Rajssss/shakti-soc/asic/e-class-aardonyx/board/README.md

# Aardonyx

FINAL SOC CONFIGURATION FOR E-CLASS:

Configuration:
1. PWM x 6
2. SPI x 3              (ADC/SDCARD/A_H)
3. GPIO x 16
4. UART x 3
5. QSPI x 1             (FLASH)
6. I2C x 2              (EEPROM/A_H)
7. SDRAM 32-bit
8. JTAG x 1 

9. FREQUENCY: 75-100Mhz
10. PACKAGE: CQFP
11. PIN COUNT MAX:103 + VCC&GND (WITH PINMUX)

Google Sheet(Aardonyx SOC I/O Pin Count):
https://docs.google.com/spreadsheets/d/1yA-pKs3_cNw3IYSj8Q-fh1bL_jA87MuPH5vjwz0L73s/edit?usp=sharing
