Rajssss/shakti-soc/asic/e-class-aardonyx/board/Board_Design/README.md

This folder contains all board design related files.

## Directory Structure

├── Aardonyx.pro        # Kicad project                     
├── board               # Kicad pcb files for Aardonyx      
├── gerber              # Gerber files for Aardonyx         
├── library             # library(symbols) used for Aardonyx  
├── modules             # moudles(footprint lib, 3d model) used for Aardonyx    
├── schematic           # schematics for Aardonyx
