Rajssss/shakti-soc/asic/e-class-aardonyx/fpga/test/artya7-100t/peripheral-tests/bsp/drivers/readme.md

This folder hosts the driver code.

List of drivers veririfed by internal testing team

Lst of drivers unverified
