Rajssss/shakti-soc/asic/e-class-aardonyx/board/Board_Design/Aardonyx.pdf

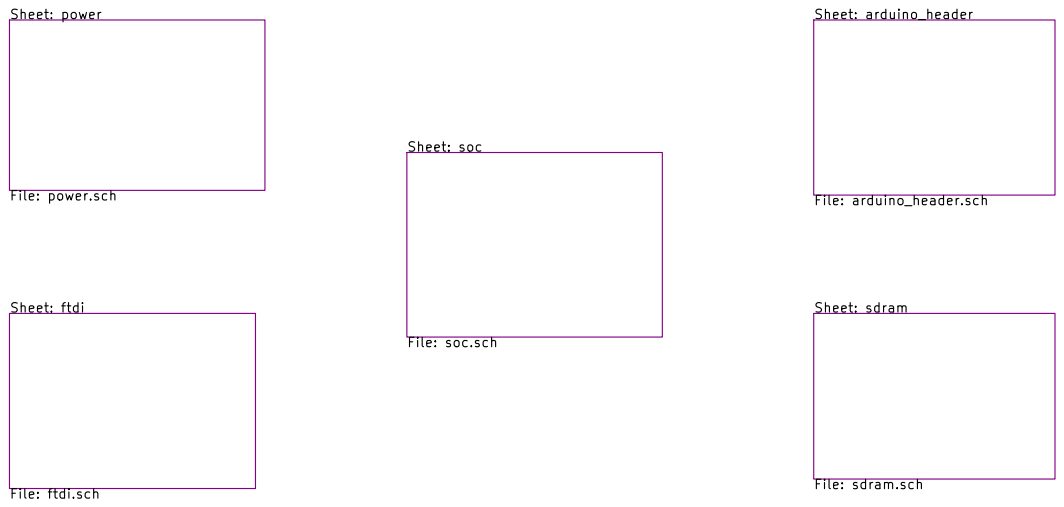
[picture p2: page 1]

File: sdram.sch Sheet: arduino_header File: arduino_header.sch Sheet: power

File: Aardonyx.sch Sheet: /
Id: 1/6 Title:

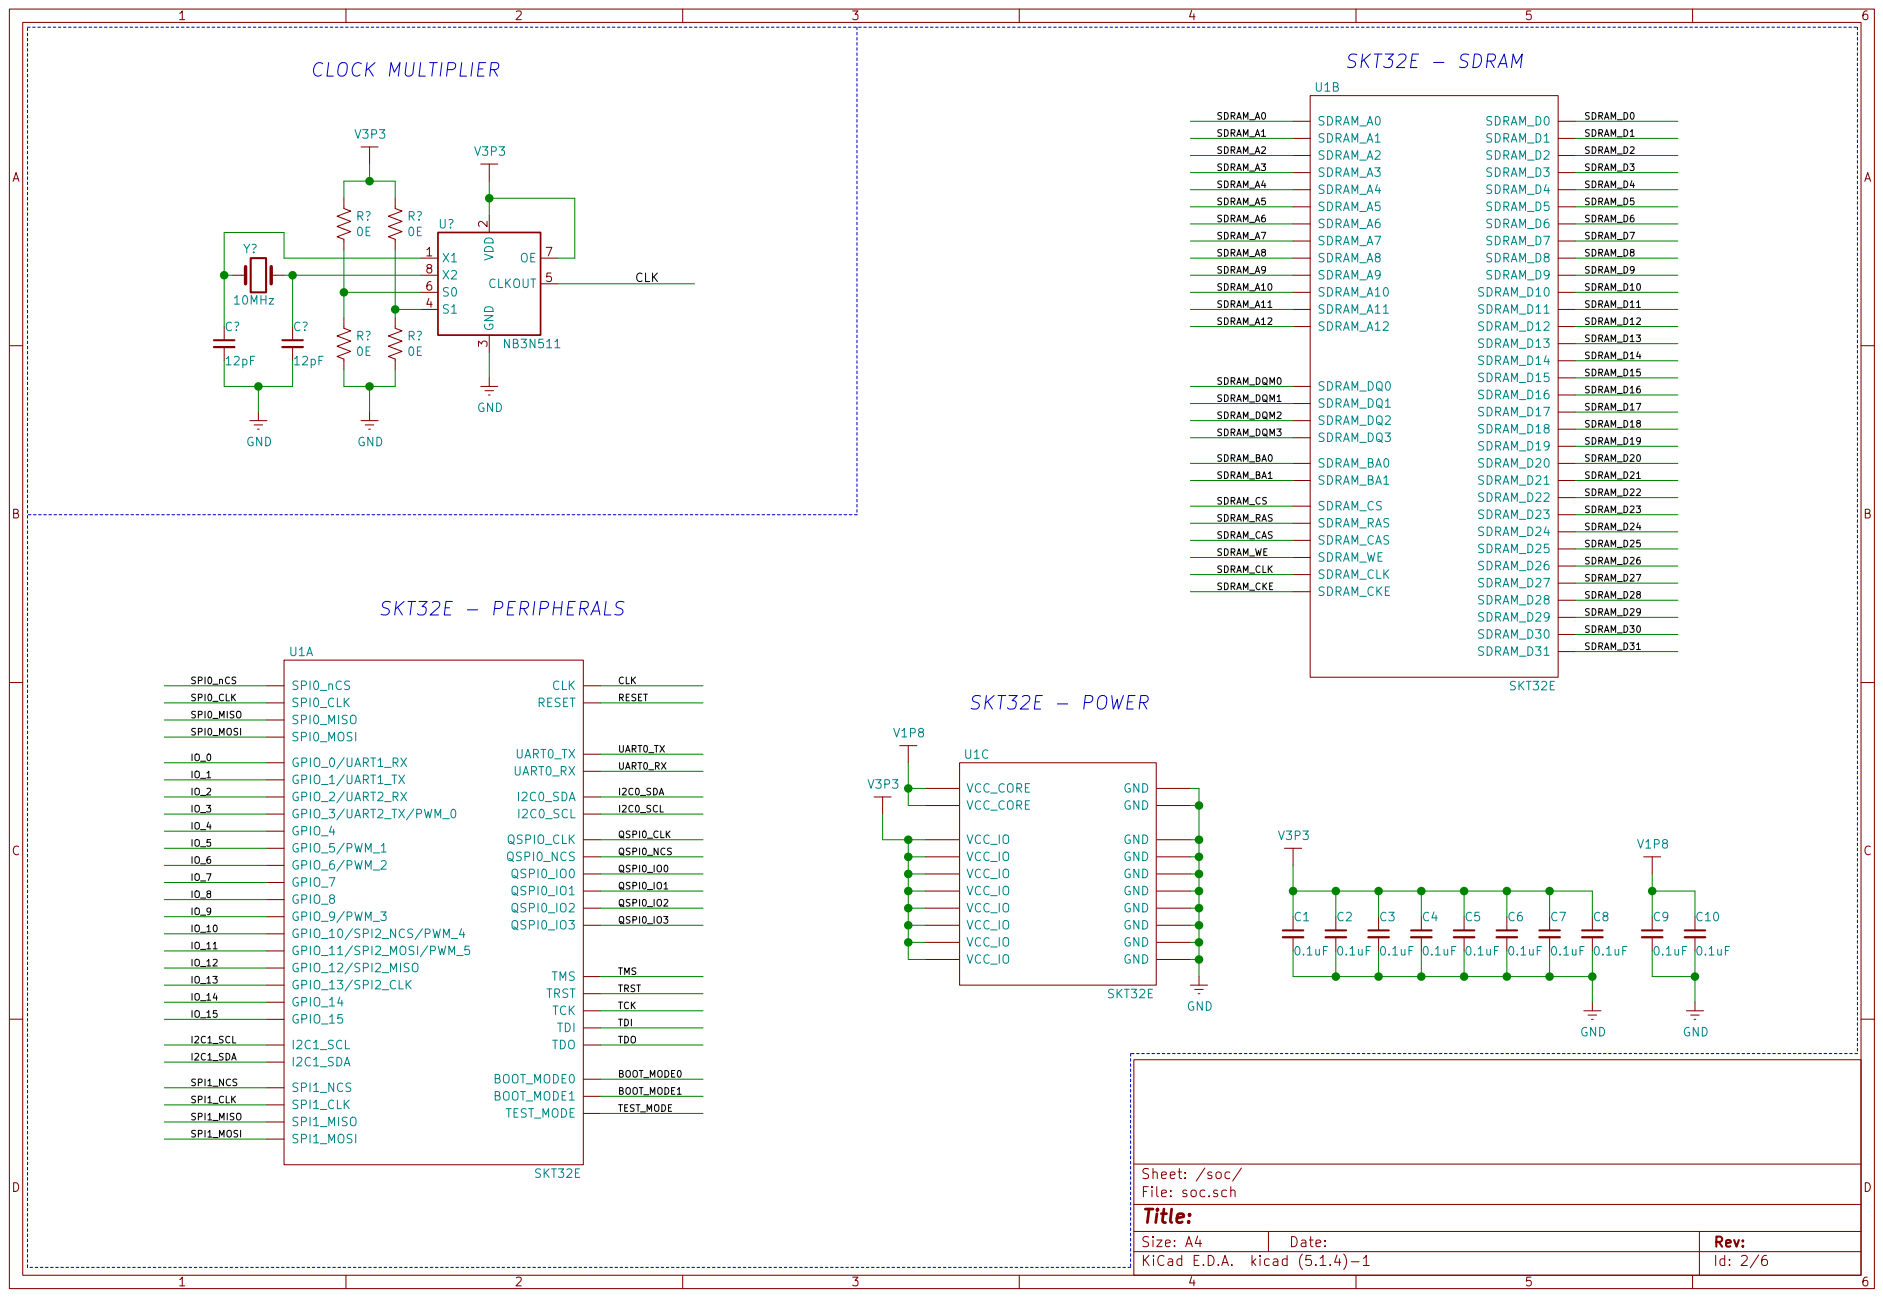
[picture p3: page 2]

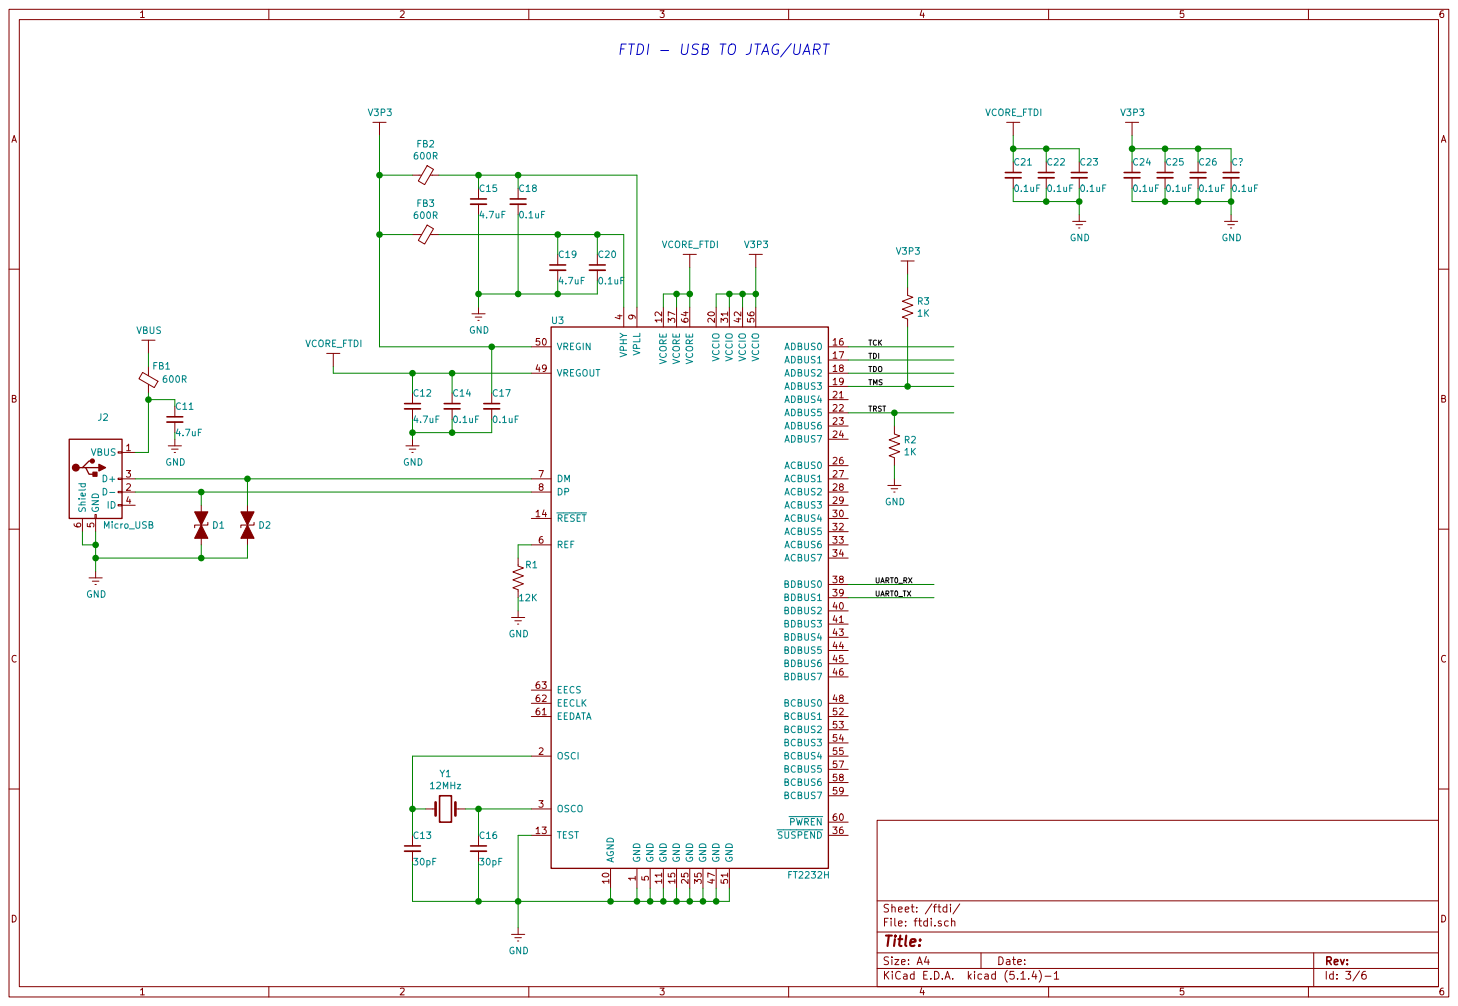
[picture p4: page 3]

TDI FTDI - USB TO JTAG/UART

1 AGND 10 GND 11 VCORE 12 TEST 13 RESET 14 GND 15 ADBUS0 16 ADBUS1 17 ADBUS2 18 ADBUS3 19 OSCI 2 VCCIO 20 ADBUS4 21 ADBUS5 22 ADBUS6 23 ADBUS7 24 GND 25 ACBUS0 26 ACBUS1 27 ACBUS2 28 ACBUS3 29 OSCO 3 ACBUS4 30 VCCIO 31 ACBUS5 32 ACBUS6 33 ACBUS7 34 GND 35 SUSPEND 36 VCORE 37 BDBUS0 38 BDBUS1 39 VPHY

4 BDBUS2 40 BDBUS3 41 VCCIO 42 BDBUS4 43 BDBUS5 44 BDBUS6 45 BDBUS7 46 GND 47 BCBUS0 48 VREGOUT 49 GND

5 VREGIN 50 GND 51 BCBUS1 52 BCBUS2 53 BCBUS3 54 BCBUS4 55 VCCIO 56 BCBUS5 57 BCBUS6 58 BCBUS7 59 REF 6 PWREN 60 EEDATA 61 EECLK 62 EECS 63 VCORE 64 DM 7 DP 8 VPLL

Id: 3/6 Title: File: ftdi.sch Sheet: /ftdi/

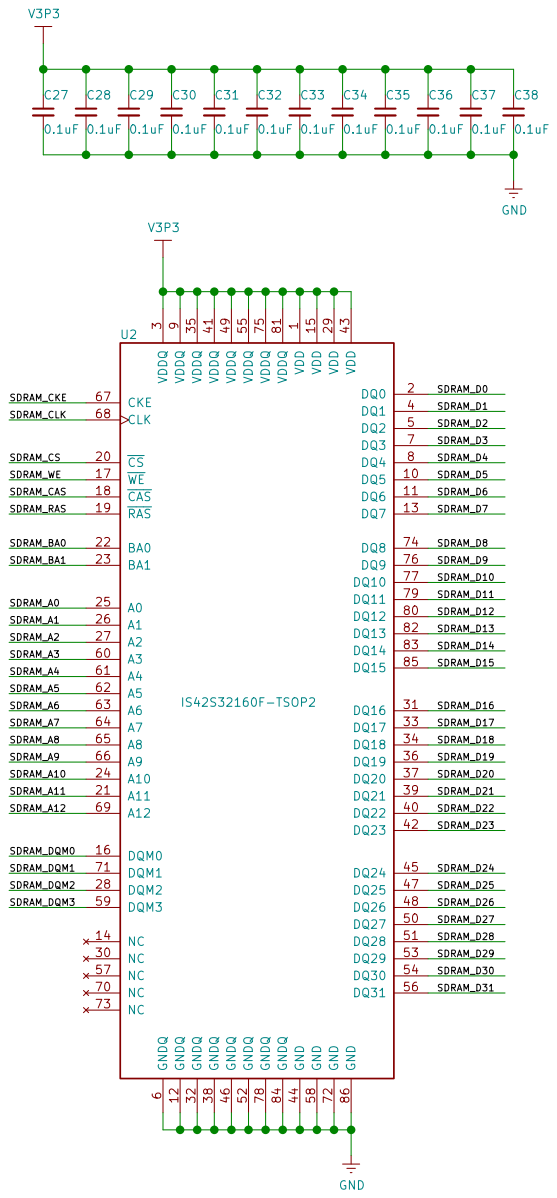
[picture p5: page 4]

Id: 4/6 Title: File: sdram.sch Sheet: /sdram/

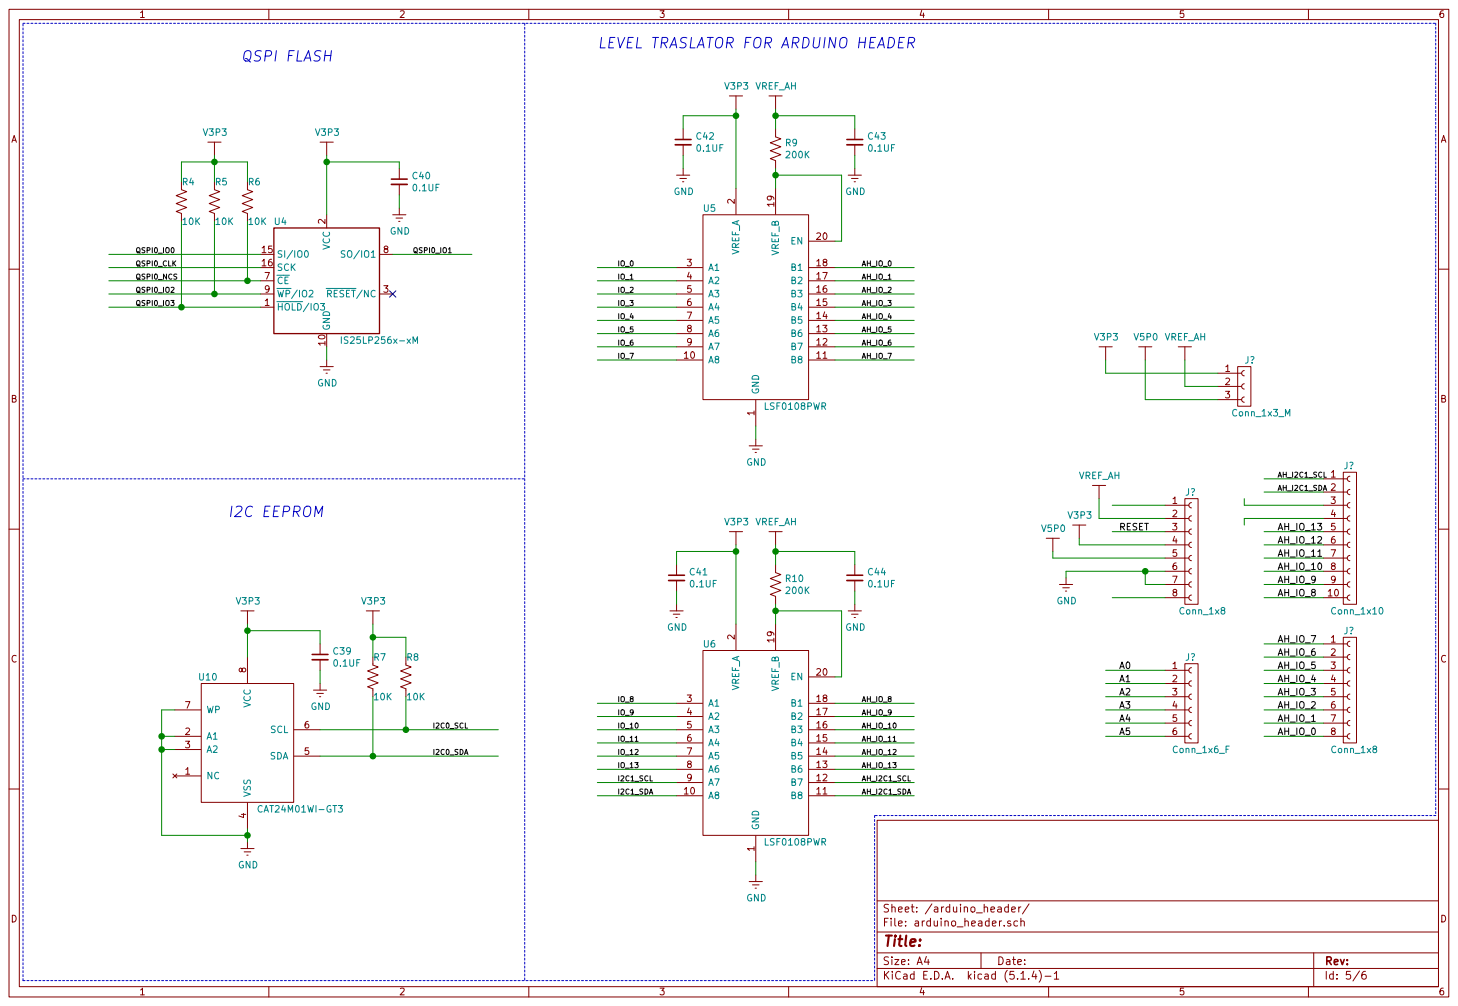
[picture p6: page 5]

AH_IO_6 AH_IO_7 AH_IO_5 AH_IO_4 LEVEL TRASLATOR FOR ARDUINO HEADER

2 RESET/NC 3 CE 7 SO/IO1 8 WP/IO2 9 U4

4 SDA 5 SCL 6 WP 7 VCC

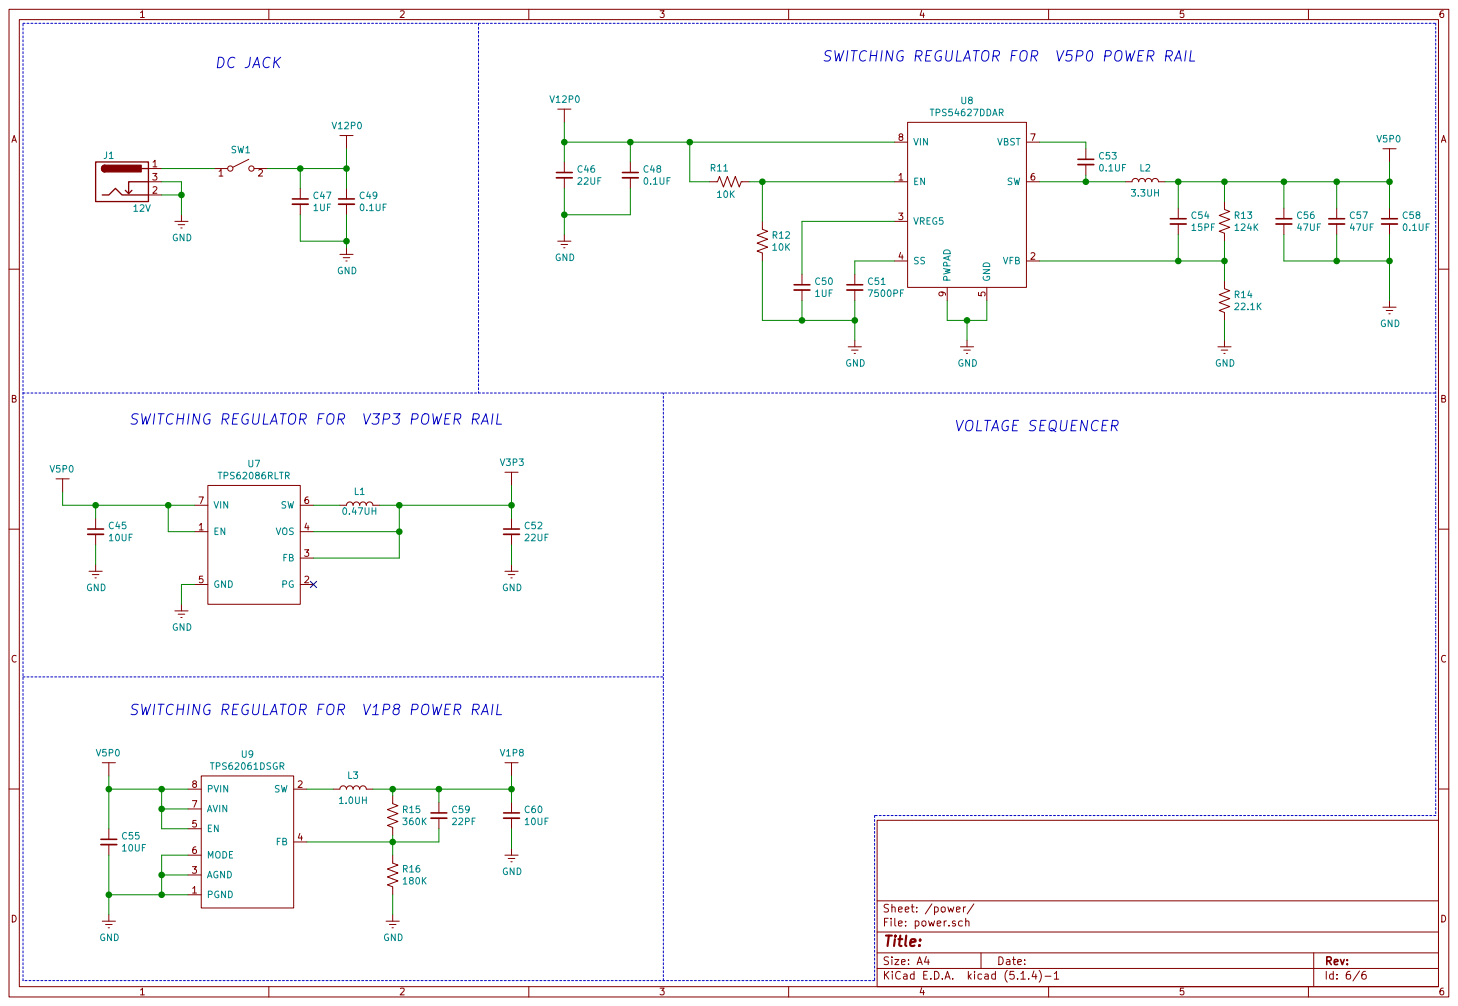
[picture p7: page 6]

SWITCHING REGULATOR FOR V5P0 POWER RAIL DC JACK
10K GND

5 SW 6 VBST 7 VIN 8 PWPAD

SWITCHING REGULATOR FOR V3P3 POWER RAIL

SWITCHING REGULATOR FOR V1P8 POWER RAIL
