Rajssss/shakti-soc/asic/e-class-aardonyx/board/Aardonyx_SOC_Pin_w_Pinmux_25_09_19.pdf

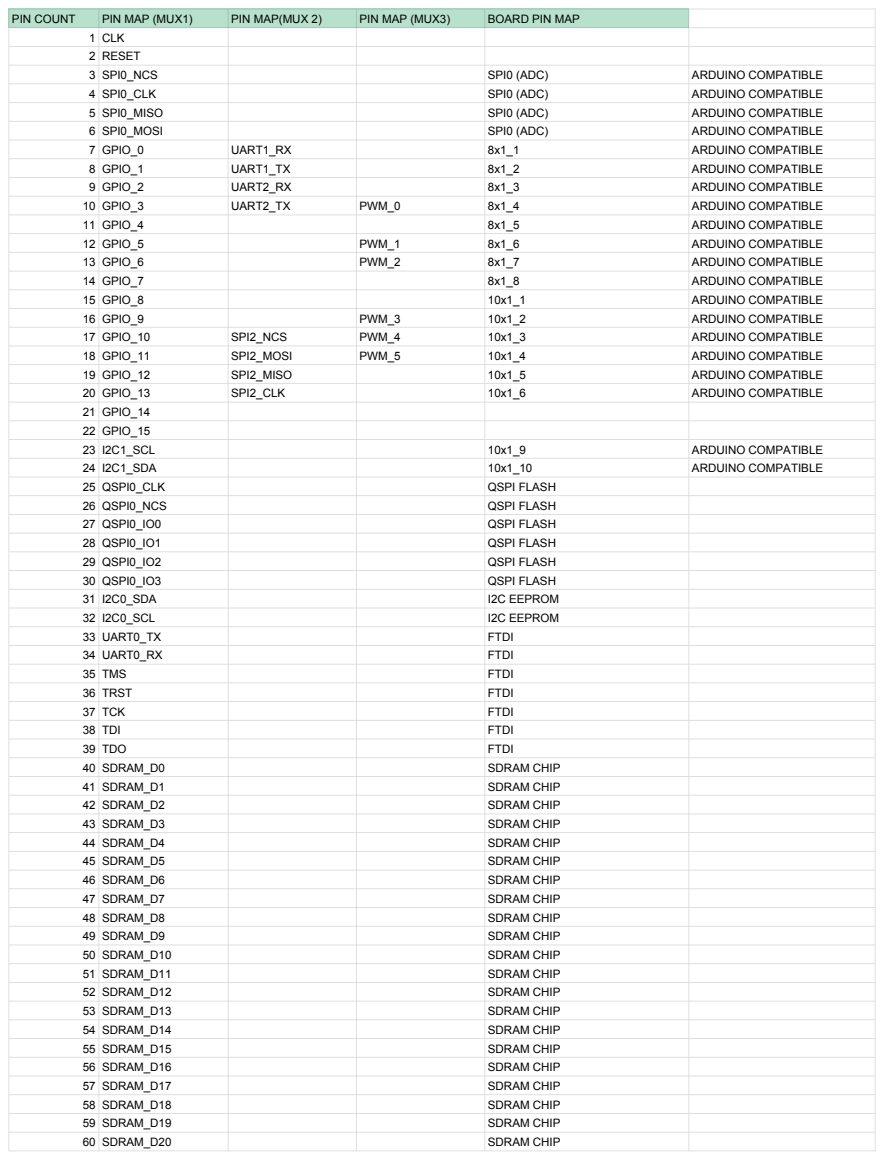
[picture p8: page 1]
PIN COUNT; PIN MAP (MUX1); PIN MAP(MUX 2); PIN MAP (MUX3); BOARD PIN MAP; 1 CLK; 2 RESET; 3 SPI0_NCS; SPI0 (ADC); ARDUINO COMPATIBLE; 4 SPI0_CLK; 5 SPI0_MISO; 6 SPI0_MOSI; 7 GPIO_0; UART1_RX; 8 GPIO_1; UART1_TX; 9 GPIO_2; UART2_RX; 10 GPIO_3; UART2_TX; PWM_0; 11 GPIO_4; 12 GPIO_5; PWM_1; 13 GPIO_6; PWM_2; 14 GPIO_7; 15 GPIO_8; 16 GPIO_9; PWM_3; 17 GPIO_10; SPI2_NCS; PWM_4; 18 GPIO_11; SPI2_MOSI; PWM_5; 19 GPIO_12; SPI2_MISO; 20 GPIO_13; SPI2_CLK; 21 GPIO_14; 22 GPIO_15; 23 I2C1_SCL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

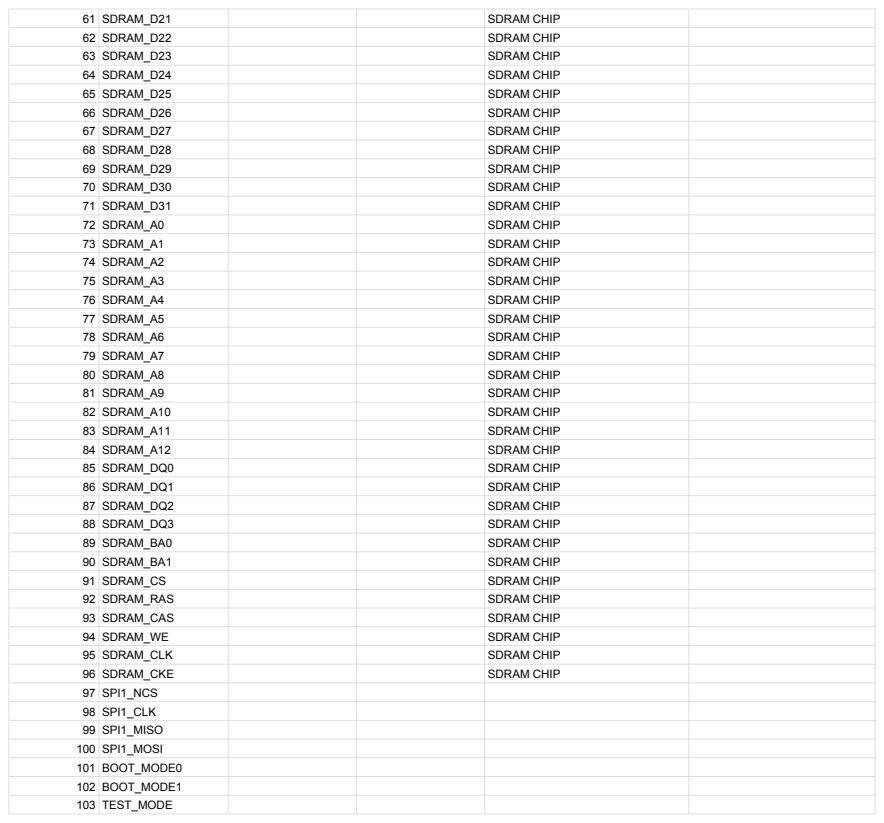
[picture p9: page 2]
61 SDRAM_D21; SDRAM CHIP; 62 SDRAM_D22; 63 SDRAM_D23; 64 SDRAM_D24; 65 SDRAM_D25; 66 SDRAM_D26; 67 SDRAM_D27; 68 SDRAM_D28; 69 SDRAM_D29; 70 SDRAM_D30; 71 SDRAM_D31; 72 SDRAM_A0; 73 SDRAM_A1; 74 SDRAM_A2; 75 SDRAM_A3; 76 SDRAM_A4; 77 SDRAM_A5; 78 SDRAM_A6; 79 SDRAM_A7; 80 SDRAM_A8; 81 SDRAM_A9; 82 SDRAM_A10; 83 SDRAM_A11; 84 SDRAM_A12; 85 SDRAM_DQ0; 86 SDRAM_DQ1; 87 SDRAM_DQ2; 88 SDRAM_DQ3; 89 SDRAM_BA0; 90 SDRAM_BA1; 91 SDRAM_CS; 92 SDRAM_RAS; 93 SDRAM_CAS; 94 SDRAM_WE; 95 SDRAM_CLK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
