Rajssss/shakti-soc/asic/e-class-aardonyx/board/Board_Design/arduino_header.sch

## KiCad design asic/e-class-aardonyx/board/Board_Design/arduino_header.sch (2019-12-17)

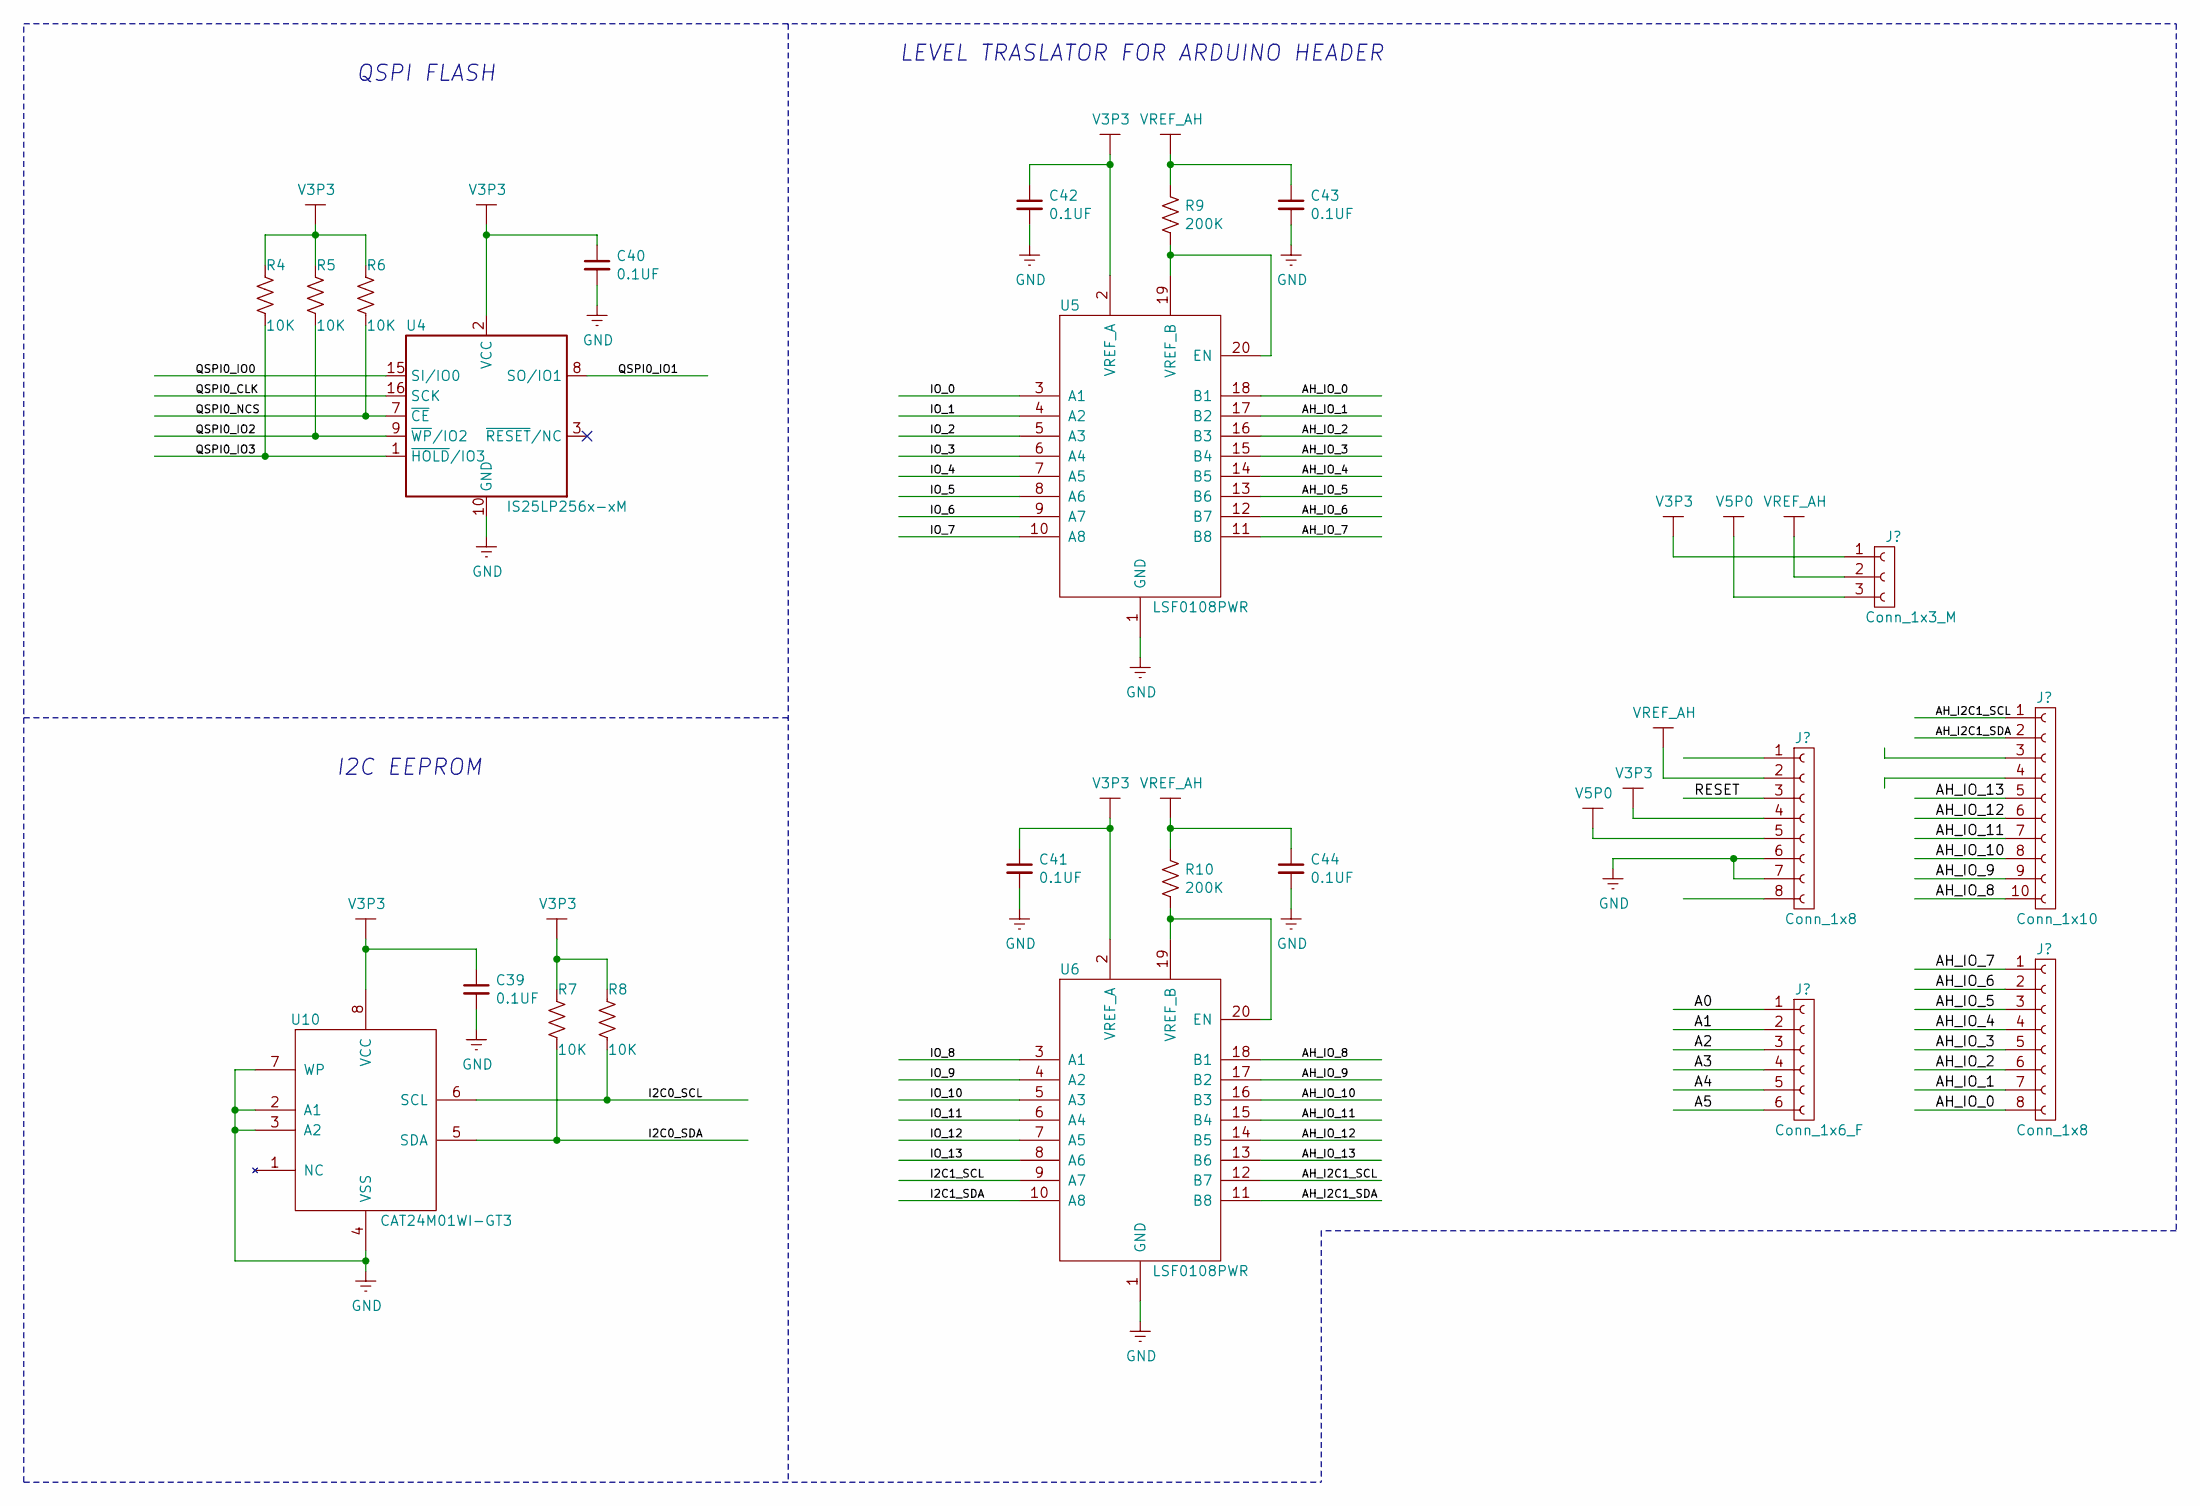
[picture p10: schematic arduino_header.sch]

Parts:
C39, C40, C41, C42, C43, C44: 0.1UF
R4, R5, R6, R7, R8: 10K
R9, R10: 200K
U4: IS25LP256x-xM; SOIC-16W_7.5x10.3mm_P1.27mm
U5, U6: LSF0108PWR
U10: CAT24M01WI-GT3

Connections:
AH_I2C1_SCL: U6.12 (B7)
AH_I2C1_SDA: U6.11 (B8)
AH_IO_0: U5.18 (B1)
AH_IO_1: U5.17 (B2)
AH_IO_2: U5.16 (B3)
AH_IO_3: U5.15 (B4)
AH_IO_4: U5.14 (B5)
AH_IO_5: U5.13 (B6)
AH_IO_6: U5.12 (B7)
AH_IO_7: U5.11 (B8)
AH_IO_8: U6.18 (B1)
AH_IO_9: U6.17 (B2)
AH_IO_10: U6.16 (B3)
AH_IO_11: U6.15 (B4)
AH_IO_12: U6.14 (B5)
AH_IO_13: U6.13 (B6)
GND: C39.2, C40.2, C41.2, C42.2, C43.2, C44.2, U4.10 (GND), U5.1 (GND), U6.1 (GND), U10.2 (A1), U10.3 (A2), U10.4 (VSS), U10.7 (WP)
I2C0_SCL: R8.2, U10.6 (SCL)
I2C0_SDA: R7.2, U10.5 (SDA)
I2C1_SCL: U6.9 (A7)
I2C1_SDA: U6.10 (A8)
IO_0: U5.3 (A1)
IO_1: U5.4 (A2)
IO_2: U5.5 (A3)
IO_3: U5.6 (A4)
IO_4: U5.7 (A5)
IO_5: U5.8 (A6)
IO_6: U5.9 (A7)
IO_7: U5.10 (A8)
IO_8: U6.3 (A1)
IO_9: U6.4 (A2)
IO_10: U6.5 (A3)
IO_11: U6.6 (A4)
IO_12: U6.7 (A5)
IO_13: U6.8 (A6)
unnamed: R9.2, U5.19 (VREF_B), U5.20 (EN)
unnamed: R10.2, U6.19 (VREF_B), U6.20 (EN)
QSPI0_CLK: U4.16 (SCK)
QSPI0_IO0: U4.15 (SI/IO0)
QSPI0_IO1: U4.8 (SO/IO1)
QSPI0_IO2: R5.2, U4.9 (~WP~/IO2)
QSPI0_IO3: R4.2, U4.1 (~HOLD~/IO3)
QSPI0_NCS: R6.2, U4.7 (~CE)
V3P3: C39.1, C40.1, C41.1, C42.1, R4.1, R5.1, R6.1, R7.1, R8.1, U4.2 (VCC), U5.2 (VREF_A), U6.2 (VREF_A), U10.8 (VCC)
VREF_AH: C43.1, C44.1, R9.1, R10.1

Notes on the sheet:
QSPI FLASH
I2C EEPROM
LEVEL TRASLATOR FOR ARDUINO HEADER
