Rajssss/shakti-soc/asic/e-class-aardonyx/board/Board_Design/ftdi.sch

## KiCad design asic/e-class-aardonyx/board/Board_Design/ftdi.sch (2019-12-17)

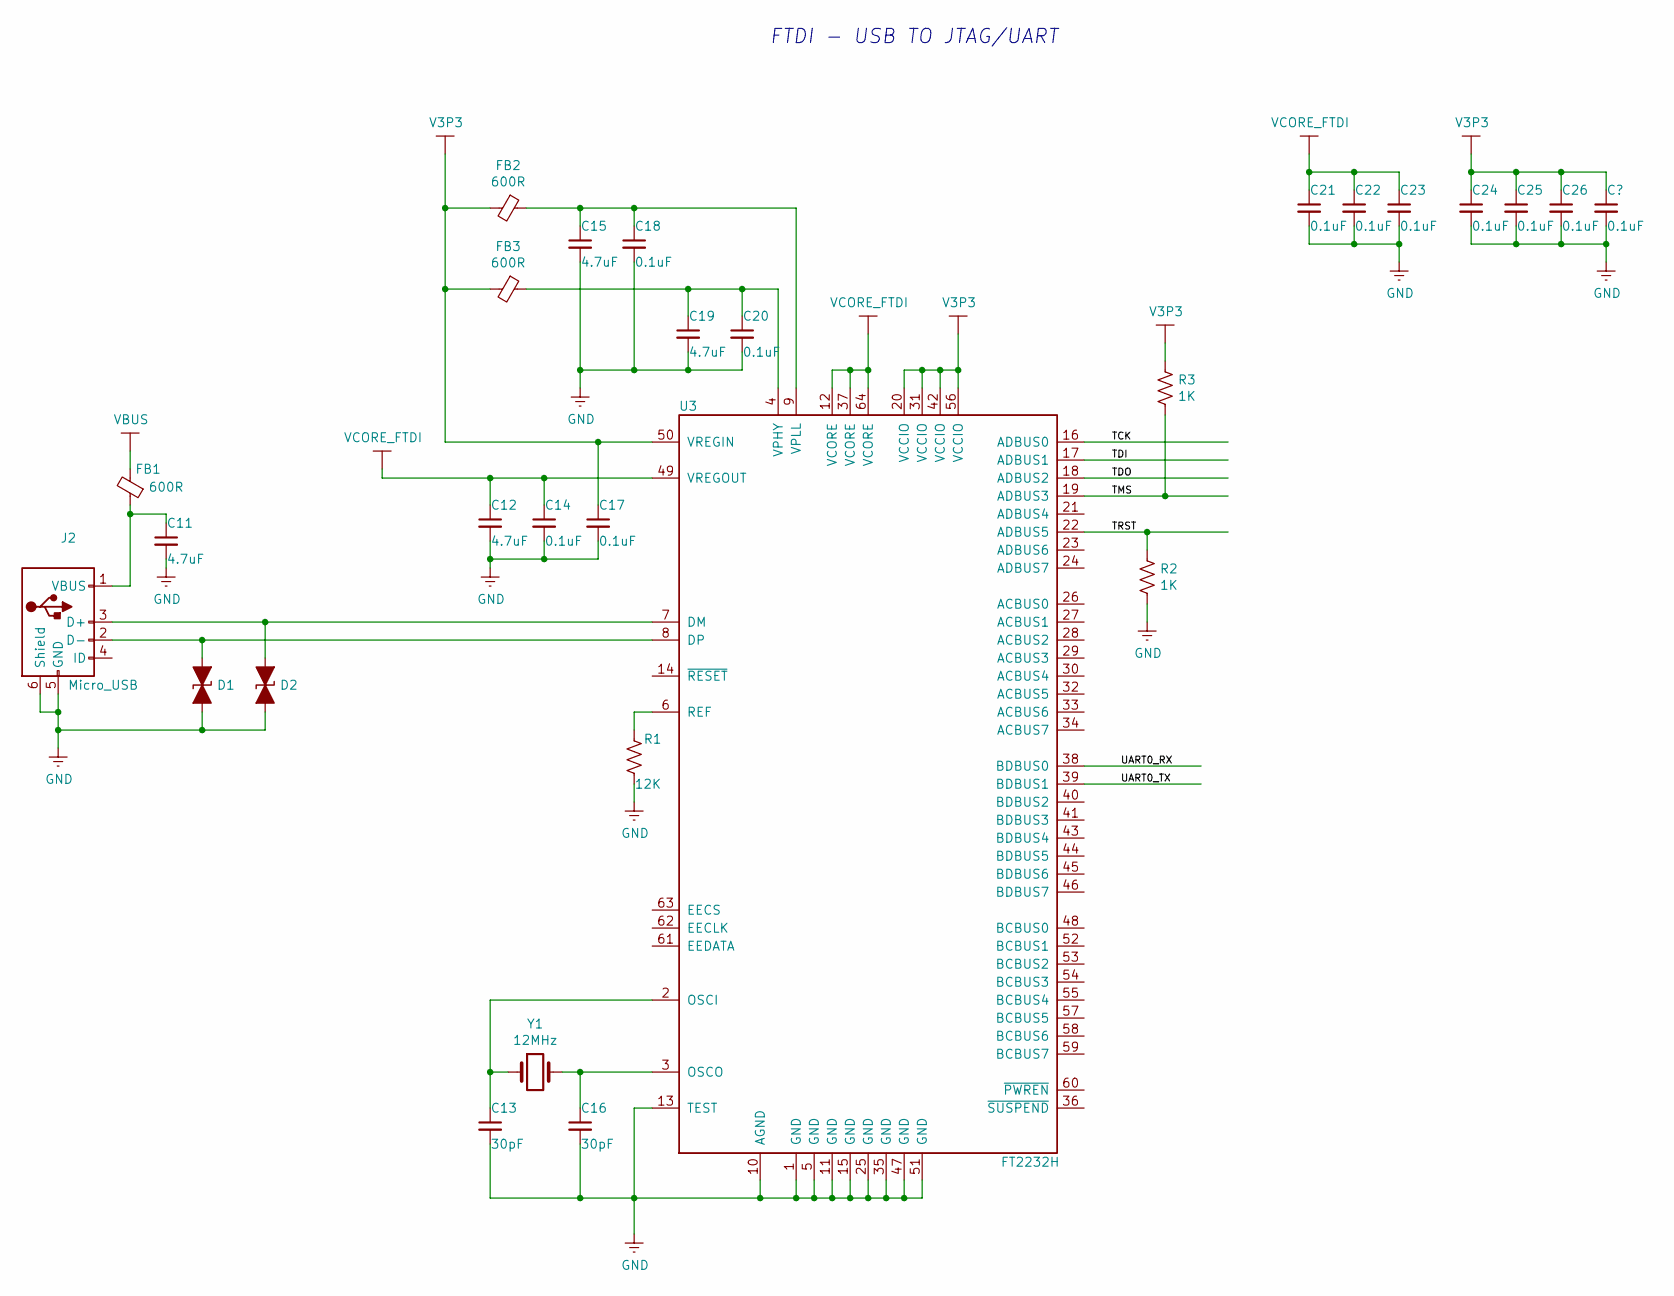
[picture p11: schematic ftdi.sch]

Parts:
C11, C12, C15, C19: 4.7uF
C13, C16: 30pF
C14, C17, C18, C20, C21, C22, C23, C24, C25, C26: 0.1uF
D1, D2: (no value)
FB1, FB2, FB3: 600R
J2: Micro_USB
R1: 12K
R2, R3: 1K
U3: FT2232H
Y1: 12MHz

Connections:
GND: C11.2, C12.2, C13.2, C14.2, C15.2, C16.2, C17.2, C18.2, C19.2, C20.2, C21.2, C22.2, C23.2, C24.2, C25.2, C26.2, D1.2 (A2), D2.2 (A2), J2.5 (GND), J2.6 (Shield), R1.2, R2.2, U3.1 (GND), U3.5 (GND), U3.10 (AGND), U3.11 (GND), U3.13 (TEST), U3.15 (GND), U3.25 (GND), U3.35 (GND), U3.47 (GND), U3.51 (GND)
unnamed: C11.1, FB1.1, J2.1 (VBUS)
unnamed: C13.1, U3.2 (OSCI), Y1.1
unnamed: C15.1, C18.1, FB2.1, U3.9 (VPLL)
unnamed: C16.1, U3.3 (OSCO), Y1.2
unnamed: C19.1, C20.1, FB3.1, U3.4 (VPHY)
unnamed: D1.1 (A1), J2.2 (D-), U3.8 (DP)
unnamed: D2.1 (A1), J2.3 (D+), U3.7 (DM)
unnamed: R1.1, U3.6 (REF)
TCK: U3.16 (ADBUS0)
TDI: U3.17 (ADBUS1)
TDO: U3.18 (ADBUS2)
TMS: R3.2, U3.19 (ADBUS3)
TRST: R2.1, U3.22 (ADBUS5)
UART0_RX: U3.38 (BDBUS0)
UART0_TX: U3.39 (BDBUS1)
V3P3: C17.1, C24.1, C25.1, C26.1, FB2.2, FB3.2, R3.1, U3.20 (VCCIO), U3.31 (VCCIO), U3.42 (VCCIO), U3.50 (VREGIN), U3.56 (VCCIO)
VBUS: FB1.2
VCORE_FTDI: C12.1, C14.1, C21.1, C22.1, C23.1, U3.12 (VCORE), U3.37 (VCORE), U3.49 (VREGOUT), U3.64 (VCORE)

Notes on the sheet:
FTDI - USB TO JTAG/UART
