Rajssss/shakti-soc/asic/e-class-aardonyx/board/Board_Design/power.sch

## KiCad design asic/e-class-aardonyx/board/Board_Design/power.sch (2019-12-17)

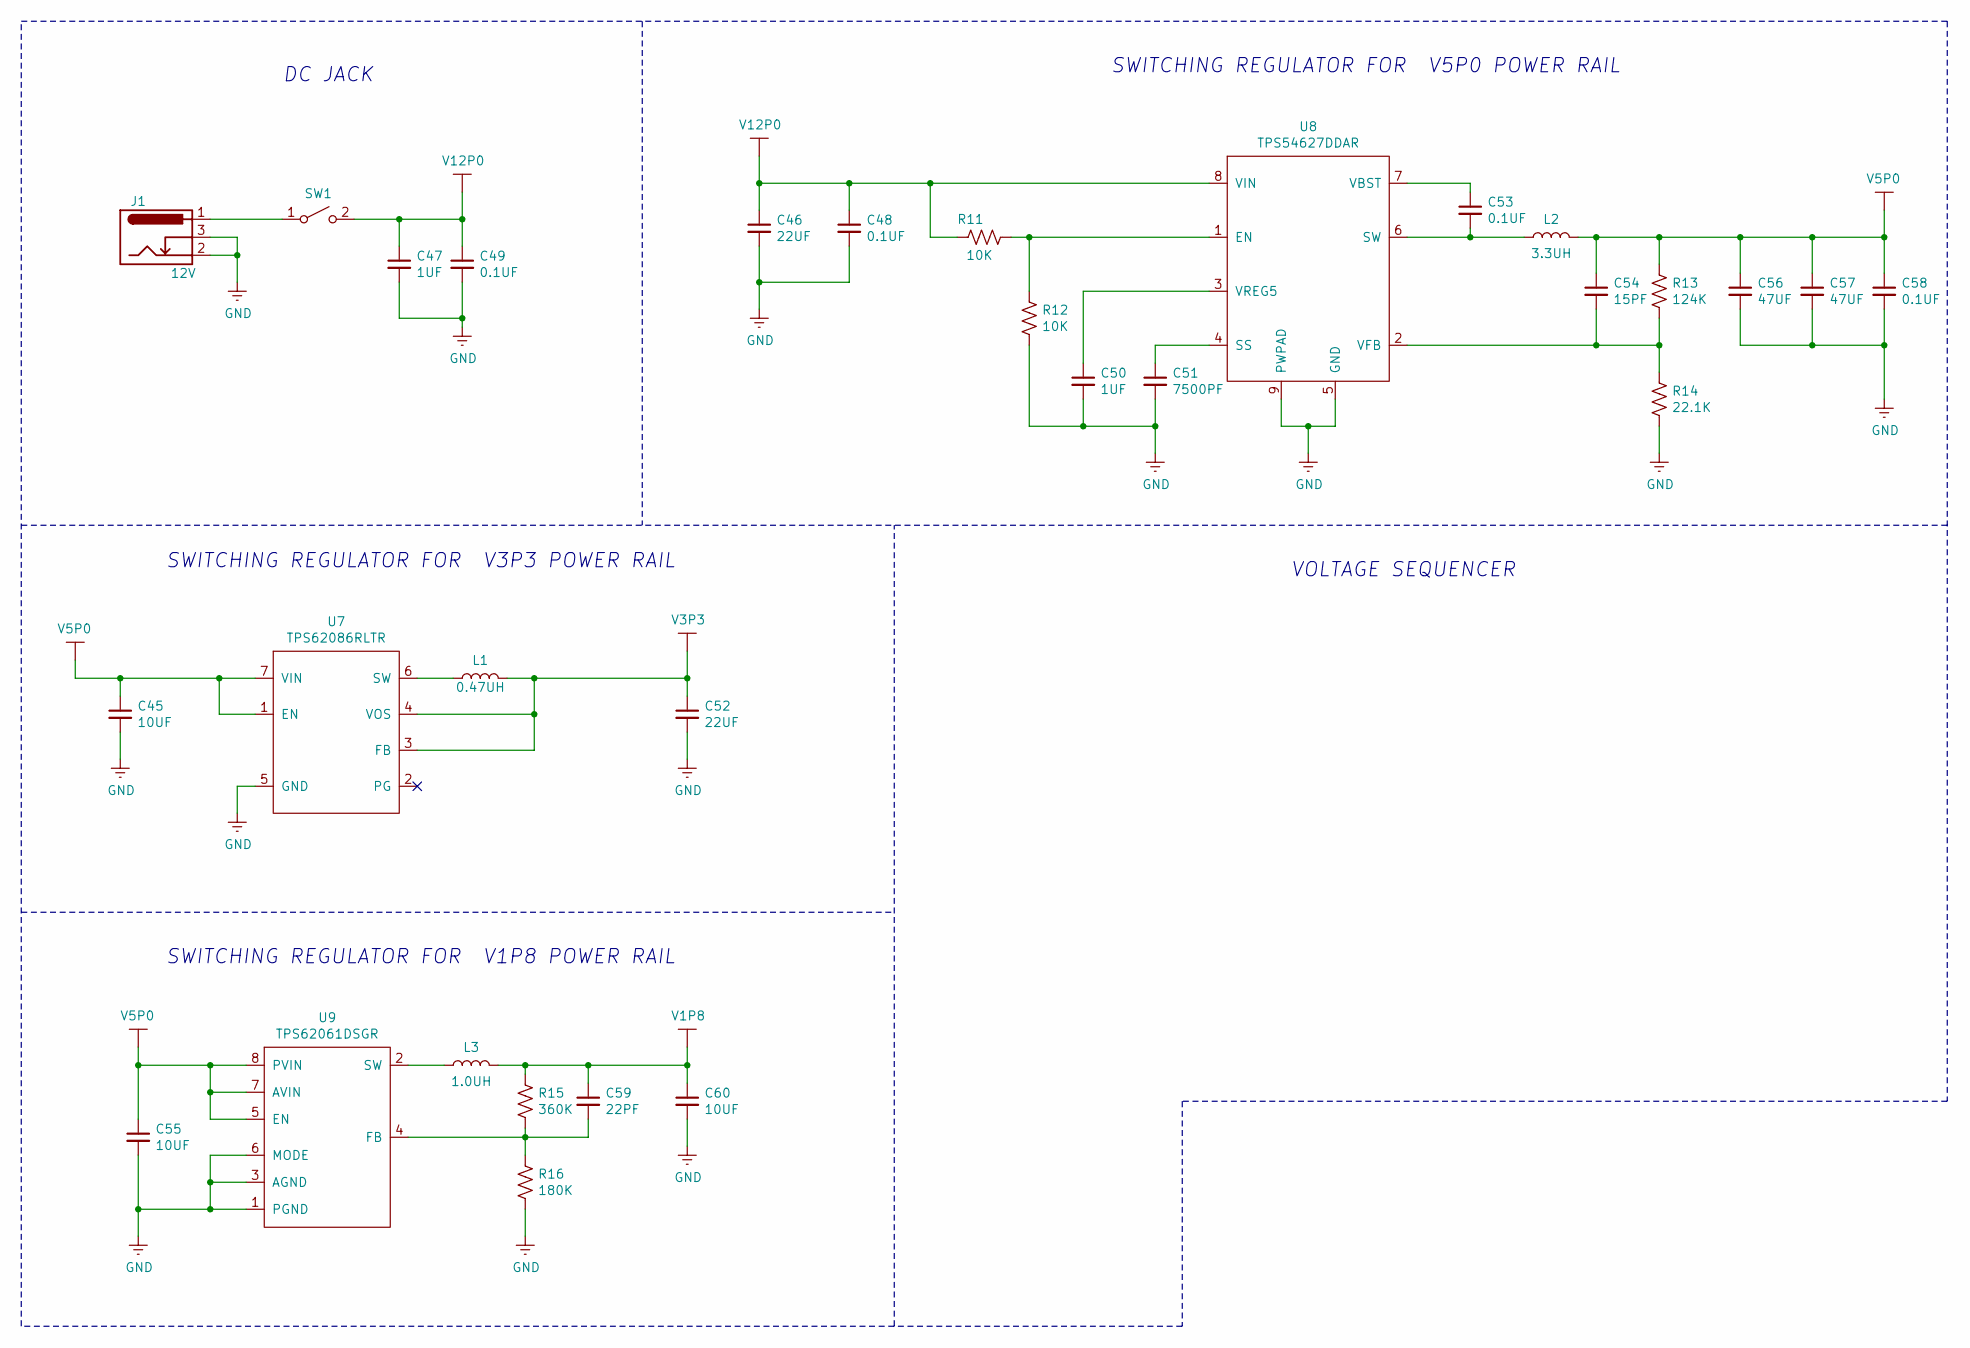
[picture p12: schematic power.sch]

Parts:
C45, C55, C60: 10UF
C46, C52: 22UF
C47, C50: 1UF
C48, C49, C53, C58: 0.1UF
C51: 7500PF
C54: 15PF
C56, C57: 47UF
C59: 22PF
J1: 12V
L1: 0.47UH
L2: 3.3UH
L3: 1.0UH
R11, R12: 10K
R13: 124K
R14: 22.1K
R15: 360K
R16: 180K
SW1: SW_SPST
U7: TPS62086RLTR
U8: TPS54627DDAR
U9: TPS62061DSGR

Connections:
GND: C45.2, C46.2, C47.2, C48.2, C49.2, C50.2, C51.2, C52.2, C55.2, C56.2, C57.2, C58.2, C60.2, J1.2, J1.3, R12.2, R14.2, R16.2, U7.5 (GND), U8.5 (GND), U8.9 (PWPAD), U9.1 (PGND), U9.3 (AGND), U9.6 (MODE)
unnamed: C50.1, U8.3 (VREG5)
unnamed: C51.1, U8.4 (SS)
unnamed: C53.1, U8.7 (VBST)
unnamed: C53.2, L2.1, U8.6 (SW)
unnamed: C54.2, R13.2, R14.1, U8.2 (VFB)
unnamed: C59.2, R15.2, R16.1, U9.4 (FB)
unnamed: J1.1, SW1.1 (A)
unnamed: L1.1, U7.6 (SW)
unnamed: L3.2, U9.2 (SW)
unnamed: R11.2, R12.1, U8.1 (EN)
V1P8: C59.1, C60.1, L3.1, R15.1
V3P3: C52.1, L1.2, U7.3 (FB), U7.4 (VOS)
V5P0: C45.1, C54.1, C55.1, C56.1, C57.1, C58.1, L2.2, R13.1, U7.1 (EN), U7.7 (VIN), U9.5 (EN), U9.7 (AVIN), U9.8 (PVIN)
V12P0: C46.1, C47.1, C48.1, C49.1, R11.1, SW1.2 (B), U8.8 (VIN)

Notes on the sheet:
SWITCHING REGULATOR FOR V5P0 POWER RAIL
SWITCHING REGULATOR FOR V3P3 POWER RAIL
SWITCHING REGULATOR FOR V1P8 POWER RAIL
VOLTAGE SEQUENCER
DC JACK
