Rajssss/shakti-soc/asic/e-class-aardonyx/board/Board_Design/sdram.sch

## KiCad design asic/e-class-aardonyx/board/Board_Design/sdram.sch (2019-12-17)

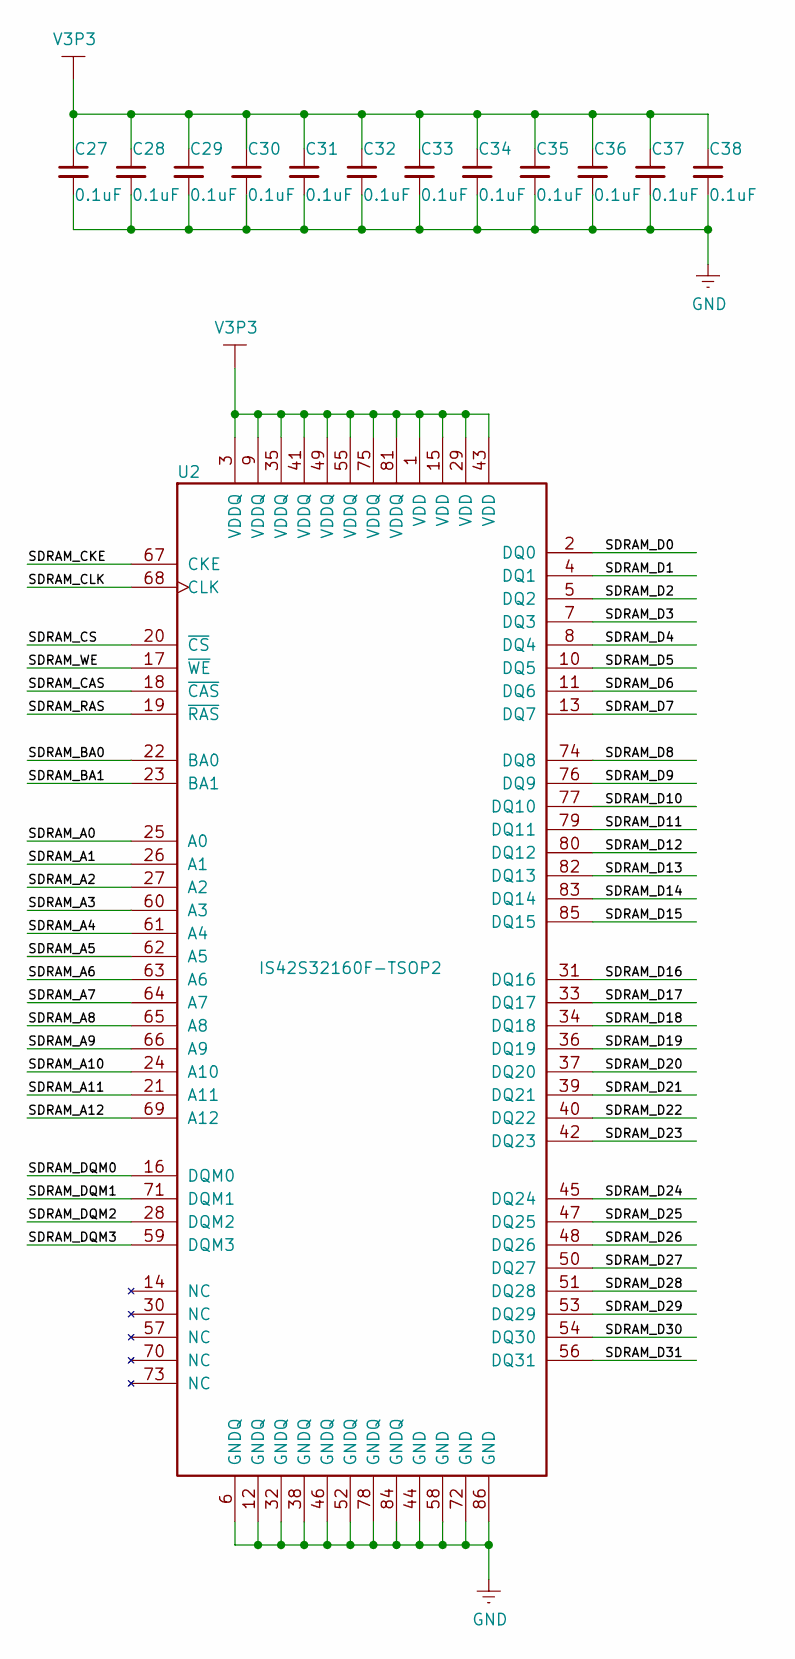
[picture p13: schematic sdram.sch]

Parts:
C27, C28, C29, C30, C31, C32, C33, C34, C35, C36, C37, C38: 0.1uF
U2: IS42S32160F-TSOP2

Connections:
GND: C27.2, C28.2, C29.2, C30.2, C31.2, C32.2, C33.2, C34.2, C35.2, C36.2, C37.2, C38.2, U2.6 (GNDQ), U2.12 (GNDQ), U2.32 (GNDQ), U2.38 (GNDQ), U2.44 (GND), U2.46 (GNDQ), U2.52 (GNDQ), U2.58 (GND), U2.72 (GND), U2.78 (GNDQ), U2.84 (GNDQ), U2.86 (GND)
SDRAM_A0: U2.25 (A0)
SDRAM_A1: U2.26 (A1)
SDRAM_A2: U2.27 (A2)
SDRAM_A3: U2.60 (A3)
SDRAM_A4: U2.61 (A4)
SDRAM_A5: U2.62 (A5)
SDRAM_A6: U2.63 (A6)
SDRAM_A7: U2.64 (A7)
SDRAM_A8: U2.65 (A8)
SDRAM_A9: U2.66 (A9)
SDRAM_A10: U2.24 (A10)
SDRAM_A11: U2.21 (A11)
SDRAM_A12: U2.69 (A12)
SDRAM_BA0: U2.22 (BA0)
SDRAM_BA1: U2.23 (BA1)
SDRAM_CAS: U2.18 (~CAS)
SDRAM_CKE: U2.67 (CKE)
SDRAM_CLK: U2.68 (CLK)
SDRAM_CS: U2.20 (~CS)
SDRAM_D0: U2.2 (DQ0)
SDRAM_D1: U2.4 (DQ1)
SDRAM_D2: U2.5 (DQ2)
SDRAM_D3: U2.7 (DQ3)
SDRAM_D4: U2.8 (DQ4)
SDRAM_D5: U2.10 (DQ5)
SDRAM_D6: U2.11 (DQ6)
SDRAM_D7: U2.13 (DQ7)
SDRAM_D8: U2.74 (DQ8)
SDRAM_D9: U2.76 (DQ9)
SDRAM_D10: U2.77 (DQ10)
SDRAM_D11: U2.79 (DQ11)
SDRAM_D12: U2.80 (DQ12)
SDRAM_D13: U2.82 (DQ13)
SDRAM_D14: U2.83 (DQ14)
SDRAM_D15: U2.85 (DQ15)
SDRAM_D16: U2.31 (DQ16)
SDRAM_D17: U2.33 (DQ17)
SDRAM_D18: U2.34 (DQ18)
SDRAM_D19: U2.36 (DQ19)
SDRAM_D20: U2.37 (DQ20)
SDRAM_D21: U2.39 (DQ21)
SDRAM_D22: U2.40 (DQ22)
SDRAM_D23: U2.42 (DQ23)
SDRAM_D24: U2.45 (DQ24)
SDRAM_D25: U2.47 (DQ25)
SDRAM_D26: U2.48 (DQ26)
SDRAM_D27: U2.50 (DQ27)
SDRAM_D28: U2.51 (DQ28)
SDRAM_D29: U2.53 (DQ29)
SDRAM_D30: U2.54 (DQ30)
SDRAM_D31: U2.56 (DQ31)
SDRAM_DQM0: U2.16 (DQM0)
SDRAM_DQM1: U2.71 (DQM1)
SDRAM_DQM2: U2.28 (DQM2)
SDRAM_DQM3: U2.59 (DQM3)
SDRAM_RAS: U2.19 (~RAS)
SDRAM_WE: U2.17 (~WE)
V3P3: C27.1, C28.1, C29.1, C30.1, C31.1, C32.1, C33.1, C34.1, C35.1, C36.1, C37.1, C38.1, U2.1 (VDD), U2.3 (VDDQ), U2.9 (VDDQ), U2.15 (VDD), U2.29 (VDD), U2.35 (VDDQ), U2.41 (VDDQ), U2.43 (VDD), U2.49 (VDDQ), U2.55 (VDDQ), U2.75 (VDDQ), U2.81 (VDDQ)
