Rajssss/shakti-soc/asic/e-class-aardonyx/board/Board_Design/soc.sch

## KiCad design asic/e-class-aardonyx/board/Board_Design/soc.sch (2019-12-17)

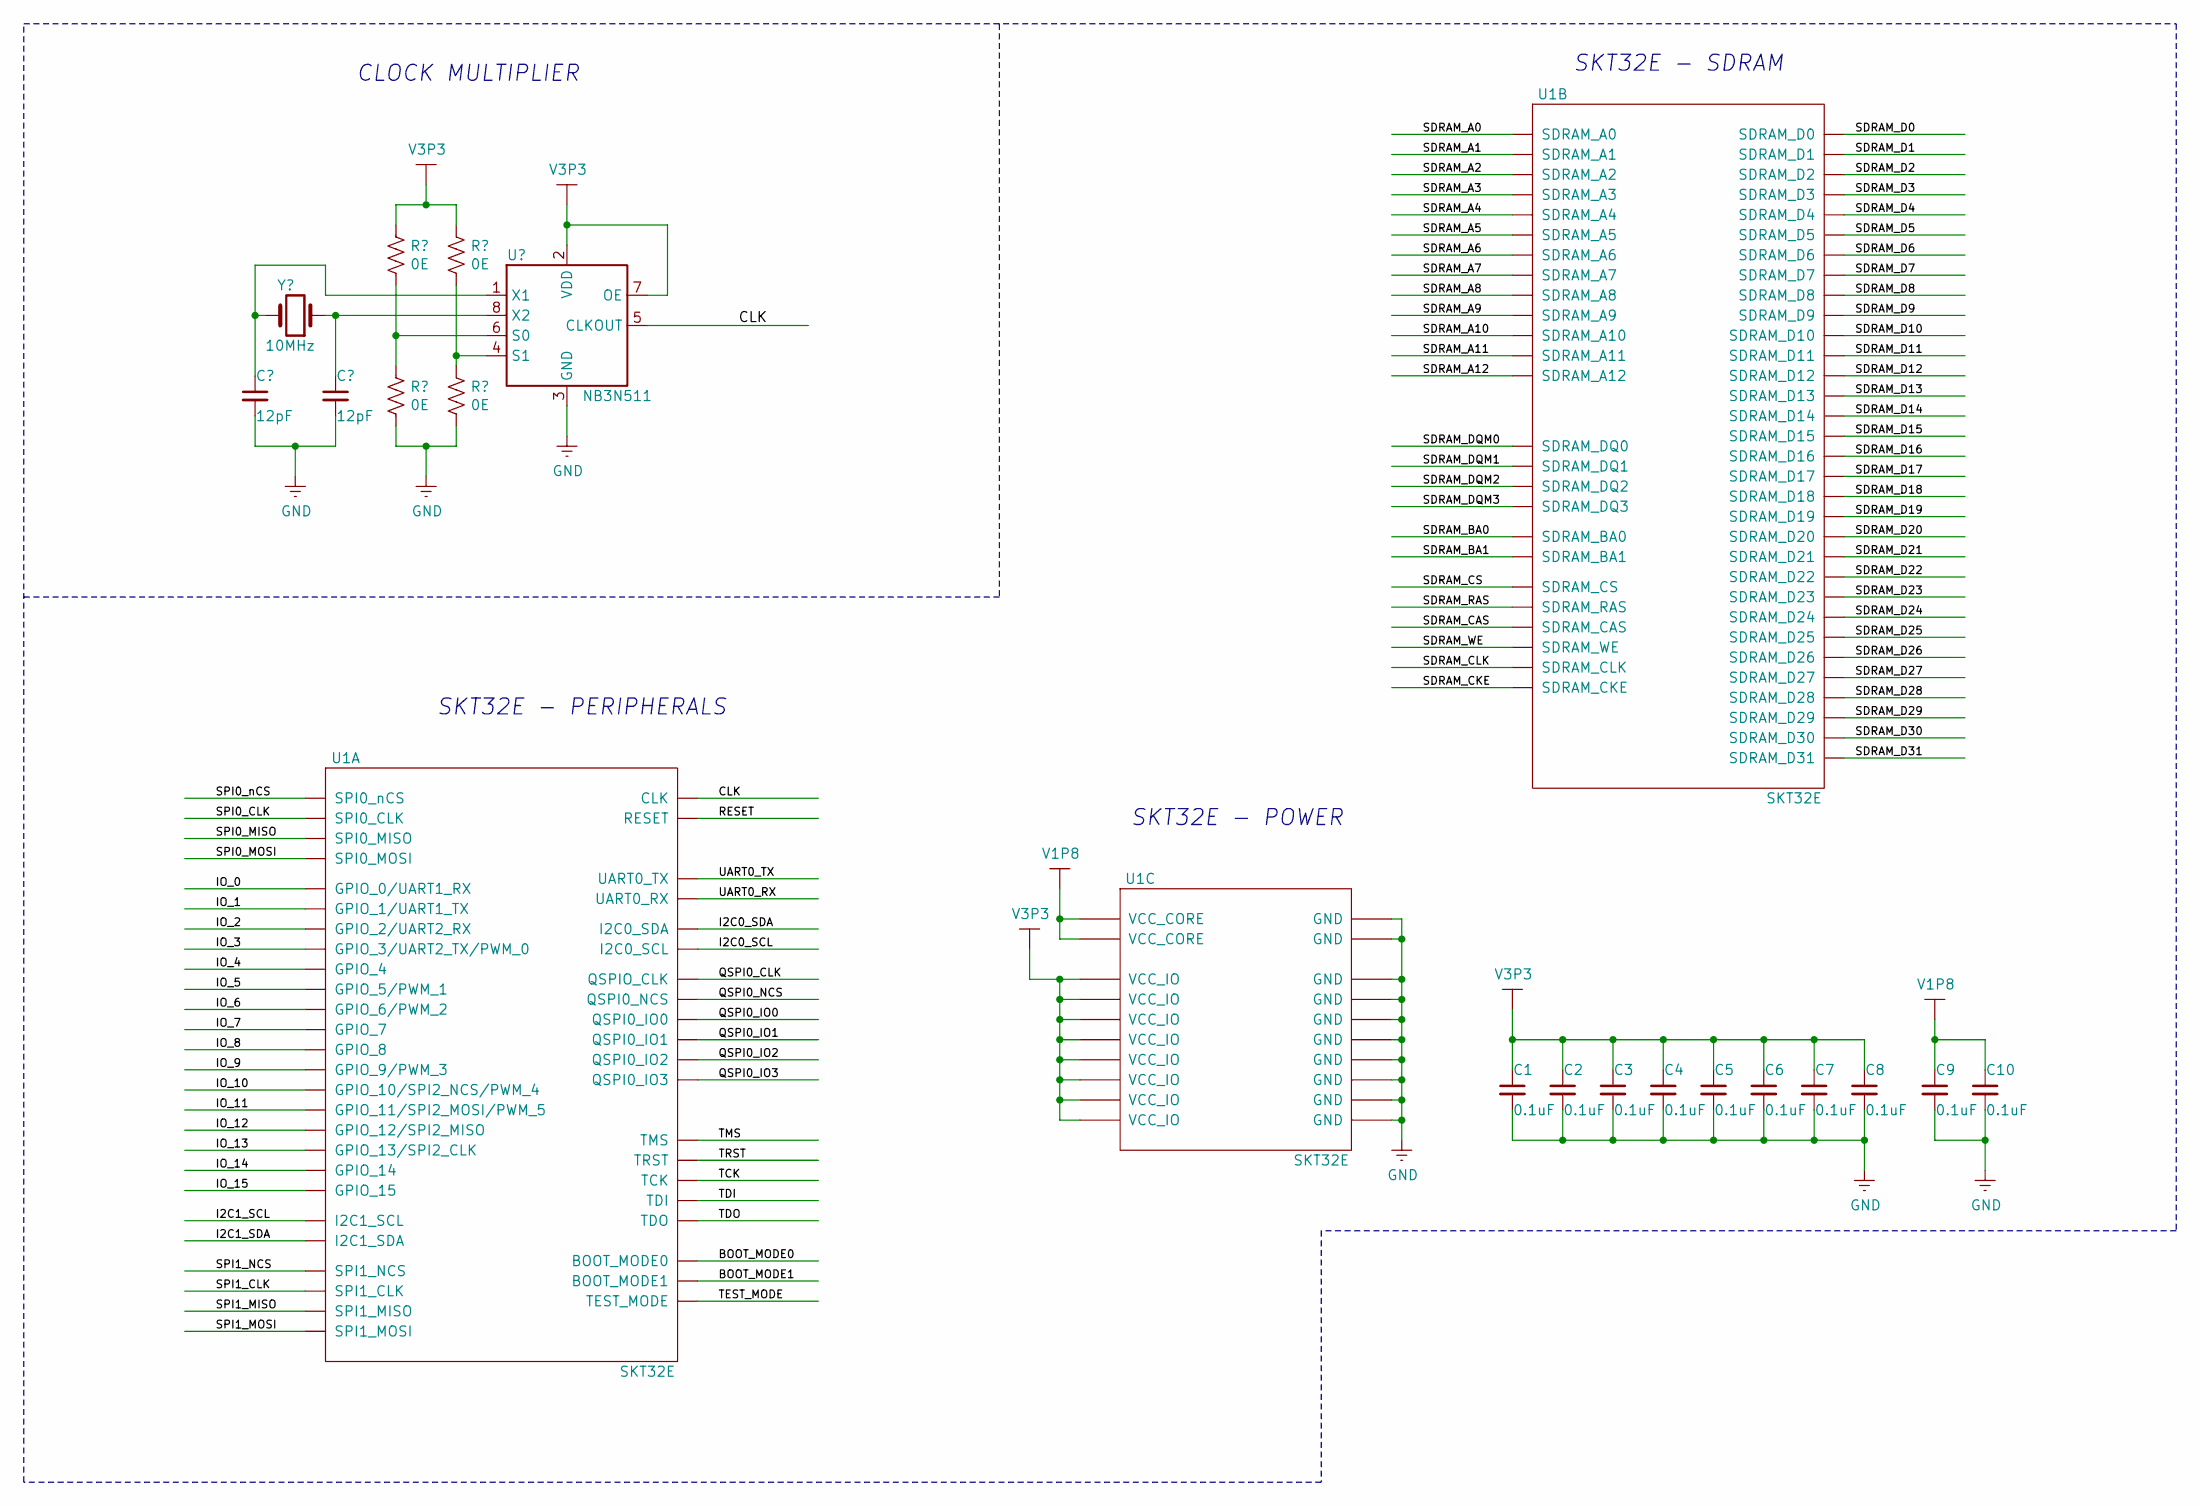
[picture p14: schematic soc.sch]

Parts:
C1, C2, C3, C4, C5, C6, C7, C8, C9, C10: 0.1uF
U1: SKT32E

Connections:
BOOT_MODE0: U1.~
BOOT_MODE1: U1.~
CLK: U1.~
GND: C1.2, C2.2, C3.2, C4.2, C5.2, C6.2, C7.2, C8.2, C9.2, C10.2, U1.~
I2C0_SCL: U1.~
I2C0_SDA: U1.~
I2C1_SCL: U1.~
I2C1_SDA: U1.~
IO_0: U1.~
IO_1: U1.~
IO_2: U1.~
IO_3: U1.~
IO_4: U1.~
IO_5: U1.~
IO_6: U1.~
IO_7: U1.~
IO_8: U1.~
IO_9: U1.~
IO_10: U1.~
IO_11: U1.~
IO_12: U1.~
IO_13: U1.~
IO_14: U1.~
IO_15: U1.~
QSPI0_CLK: U1.~
QSPI0_IO0: U1.~
QSPI0_IO1: U1.~
QSPI0_IO2: U1.~
QSPI0_IO3: U1.~
QSPI0_NCS: U1.~
RESET: U1.~
SDRAM_A0: U1.~
SDRAM_A1: U1.~
SDRAM_A2: U1.~
SDRAM_A3: U1.~
SDRAM_A4: U1.~
SDRAM_A5: U1.~
SDRAM_A6: U1.~
SDRAM_A7: U1.~
SDRAM_A8: U1.~
SDRAM_A9: U1.~
SDRAM_A10: U1.~
SDRAM_A11: U1.~
SDRAM_A12: U1.~
SDRAM_BA0: U1.~
SDRAM_BA1: U1.~
SDRAM_CAS: U1.~
SDRAM_CKE: U1.~
SDRAM_CLK: U1.~
SDRAM_CS: U1.~
SDRAM_D0: U1.~
SDRAM_D1: U1.~
SDRAM_D2: U1.~
SDRAM_D3: U1.~
SDRAM_D4: U1.~
SDRAM_D5: U1.~
SDRAM_D6: U1.~
SDRAM_D7: U1.~
SDRAM_D8: U1.~
SDRAM_D9: U1.~
SDRAM_D10: U1.~
SDRAM_D11: U1.~
SDRAM_D12: U1.~
SDRAM_D13: U1.~
SDRAM_D14: U1.~
SDRAM_D15: U1.~
SDRAM_D16: U1.~
SDRAM_D17: U1.~
SDRAM_D18: U1.~
SDRAM_D19: U1.~
SDRAM_D20: U1.~
SDRAM_D21: U1.~
SDRAM_D22: U1.~
SDRAM_D23: U1.~
SDRAM_D24: U1.~
SDRAM_D25: U1.~
SDRAM_D26: U1.~
SDRAM_D27: U1.~
SDRAM_D28: U1.~
SDRAM_D29: U1.~
SDRAM_D30: U1.~
SDRAM_D31: U1.~
SDRAM_DQM0: U1.~
SDRAM_DQM1: U1.~
SDRAM_DQM2: U1.~
SDRAM_DQM3: U1.~
SDRAM_RAS: U1.~
SDRAM_WE: U1.~
SPI0_CLK: U1.~
SPI0_MISO: U1.~
SPI0_MOSI: U1.~
SPI0_nCS: U1.~
SPI1_CLK: U1.~
SPI1_MISO: U1.~
SPI1_MOSI: U1.~
SPI1_NCS: U1.~
TCK: U1.~
TDI: U1.~
TDO: U1.~
TEST_MODE: U1.~
TMS: U1.~
TRST: U1.~
UART0_RX: U1.~
UART0_TX: U1.~
V1P8: C9.1, C10.1, U1.~
V3P3: C1.1, C2.1, C3.1, C4.1, C5.1, C6.1, C7.1, C8.1, U1.~

Notes on the sheet:
CLOCK MULTIPLIER
SKT32E - SDRAM
SKT32E - PERIPHERALS
SKT32E - POWER
