Rajssss/shakti-soc/asic/e-class-aardonyx/fpga/test/artya7-100t/peripheral-tests/bsp/include/gpio_i2c.h

/***************************************************************************
* Project           			:  shakti devt board
* Name of the file	     		:  gpio_i2c.h
* Created date			        :  9.07.2019
* Brief Description of file             :  Header file the I2C operations using gpio pins.
* Name of Author    	                :  Kotteeswaran
* Email ID                              :  kottee.1@gmail.com

    Copyright (C) 2019  IIT Madras. All rights reserved.

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
***************************************************************************/
#ifndef GPIO_I2C_H
#define GPIO_I2C_H

#include "platform.h"
#include "gpio.h"

#define I2C_SCL GPIO0
#define I2C_SDA GPIO1
#define GPIOD_IS_IN 0
#define GPIOD_IS_OUT 1
#define I2C_WRITE 0
#define I2C_READ 1

void I2cInit();
void I2cSendSlaveAddress(unsigned char , unsigned char , unsigned char );
void I2cWriteByte(unsigned char , unsigned char );
unsigned char I2cReadByte(unsigned char );
void I2cWriteData(unsigned char , unsigned char );
unsigned char I2cReadDataAck(unsigned char );
unsigned char I2cReadDataNack(unsigned char );
void I2cStart(unsigned char );
void I2cStop(unsigned char );
void I2c_Write_byte(unsigned char ,unsigned char , unsigned char , unsigned char);
int I2c_Read_byte(unsigned char ,unsigned char , unsigned char );
int I2c_shakti_readbytes(char *, int , int , unsigned char );
void ReadAckForWrite(unsigned char delay);
void SendNackForRead(unsigned char delay);
void SendAckForRead(unsigned char delay);


#endif
