Rajssss/shakti-soc/asic/e-class-aardonyx/fpga/test/artya7-100t/peripheral-tests/bsp/drivers/spi/gpio_spi.c

#include "platform.h"
#include "gpio.h"
#include "gpio_spi.h"



// at starting  edge sending
static void writebyte(unsigned char writeData, unsigned char delay)
{
	unsigned char j=0,k;
	unsigned long readData = 0;
	//readData = read_word(GPIO_DATA_REG);

    // Before initiating communication SS -> low
       write_word(GPIO_DATA_REG, (read_word(GPIO_DATA_REG) & ~(SPI_SS)) );
	while(j < 8)
	{
		k = writeData;
		k = ( k << j ) & 0x80;

        // lowering sck --> FALLING EDGE 
        //write_word(GPIO_DATA_REG, (read_word(GPIO_DATA_REG) & ~(SPI_SCLK)) );
        // increasing sck --> Rising EDGE
        write_word(GPIO_DATA_REG, (read_word(GPIO_DATA_REG) | SPI_SCLK) );

        if(k == 0)
		{
			write_word(GPIO_DATA_REG, (read_word(GPIO_DATA_REG) & ~(SPI_MOSI)) );
			DelayLoop(delay, delay);
		}

		else
		{
			write_word(GPIO_DATA_REG, (read_word(GPIO_DATA_REG) | SPI_MOSI) );
			DelayLoop(delay, delay);
		}

        //DelayLoop(delay,delay);
        // making sck up 
		//write_word(GPIO_DATA_REG, (read_word(GPIO_DATA_REG) | SPI_SCLK));
        // sck down
        write_word(GPIO_DATA_REG, (read_word(GPIO_DATA_REG) & ~(SPI_SCLK)) );
        //DelayLoop(delay, delay);
		++j;
	}
        // MAKE SS PIN high after transfer of a byte
        write_word(GPIO_DATA_REG, (read_word(GPIO_DATA_REG) |SPI_SS ));
}

//reading at rising edge reading 
unsigned char readbyte(unsigned char delay)
{
	unsigned char j = 0, i = 0;
	unsigned char bitValue;
	unsigned char readData = 0;
        unsigned long readGpioData = 0;
	readData = read_word(GPIO_DATA_REG);
	while(j < 8)
	{
		write_word(GPIO_DATA_REG, (read_word(GPIO_DATA_REG) | SPI_SCLK) );
		DelayLoop(delay, delay);

		readGpioData = read_word(GPIO_DATA_REG)  & SPI_MISO;

        if(readGpioData != 0)
			bitValue = 1;
		else
			bitValue = 0;
	    
        readData = readData << 1;
		readData = readData | bitValue;
		
        DelayLoop(delay, delay);

		write_word(GPIO_DATA_REG, (read_word(GPIO_DATA_REG) & ~(SPI_SCLK)));
		DelayLoop(delay, delay);
		++j;
	}
	return readData;
}

/*
  1.) MISO_pin  --> 1st GPIO //0 
  2.) MOSI_pin -->  2nd GPIO // 1
  3.) SCLK_pin -->  3rth GPIO // 1
  4.) SS_Pin   -->  4th GPIO  // 1
*/


int config()
{
    write_word(GPIO_DIRECTION_CNTRL_REG, (read_word(GPIO_DIRECTION_CNTRL_REG) & ~(SPI_MISO)));
    write_word(GPIO_DIRECTION_CNTRL_REG, (read_word(GPIO_DIRECTION_CNTRL_REG) | SPI_MOSI));
    write_word(GPIO_DIRECTION_CNTRL_REG, (read_word(GPIO_DIRECTION_CNTRL_REG) | SPI_SS));
    write_word(GPIO_DIRECTION_CNTRL_REG, (read_word(GPIO_DIRECTION_CNTRL_REG) | SPI_SCLK));
    unsigned char writeData = (int) 'a';
    unsigned char delay = 10;
    for (;;)
    {
    writebyte(writeData,delay);
    printf("%d\n",writeData);
    DelayLoop(100,120);
    }
}
