Rajssss/shakti-soc/(commit log)

2019-04-27 init_calib_complete to be connected to memory device as well
2019-04-27 use board instead of fpga part
2019-04-27 use board instead of fpga part no
2019-04-27 adding gdb and openocd scripts
    [shakti_ocd.cfg]
2019-04-27 Changed interface to jlink and added adapter speed parameter in OpenOCD config file
    [shakti_ocd.cfg]
2019-04-27 Added GPIO, PLIC and I2C in SoC
2019-04-29 fetching specific commits instead of masters for all repo
    Will switch to using tags once follow that procedure for all repos.
2019-05-21 Resolve "DDR3 burst mode not working"
    [fpga_top.v]
2019-06-01 initial push for e-class on arty-a7100t
    [shakti_ocd.cfg]
2019-06-04 create a cluster for spi, uart and pwms
    [shakti_ocd.cfg]
2019-06-04 top level Soc done
    interrupts need to be integrated
2019-06-04 interrupts need to be always enabled
2019-06-04 memory mapped done.
    interrupt integration done.
2019-06-06 Added BRAM memory in Soc and SPI constraints
2019-06-06 updated constraints with currently supported ips
2019-06-06 pull latest e-class and latest devices
2019-06-12 initial template of aardonyx done
    [shakti_ocd.cfg]
2019-06-13 Support For the artys onboard jtag tap.
    needs a patch on openocd , in process to upstream
    [shakti-arty.cfg, shakti_ocd.cfg]
2019-06-13 support for c/e bscan 100ttested with upstream
    [shakti-arty.cfg, shakti_ocd.cfg]
2019-06-20 Jtag and Arty chains , readme and additional build options
    [shakti-jlink-jtag.cfg]
2019-06-29 updating e-class and device versions
2019-07-01 update devices with new qspi changes
2019-07-02 fixed qspi pin mapping
    [aardonyx.v]
2019-07-08 updating devices for e-class to 3.5.2
2019-07-19 updating devices to 3.6.0
    sdram latch issues fixed
2019-07-20 bumping devices versions
2019-07-25 Resolve "e-class-mukut"
    [shakti_ocd.cfg]
2019-07-26 Support for the e-class on 35t with the integrated debugger
    and seperate make target to build mcs file
    [shakti-arty.cfg, shakti-jlink-jtag.cfg]
2019-08-05 udpating e-class and devices versions
2019-08-06 updating spi module
2019-08-16 fixed fpga_top for more gpios
    [fpga_top.v]
2019-08-16 fixed fpga_top wire width. allow rebuilding hierarchy
    [fpga_top.v]
2019-08-23 run ci on all changes under boards directory. This is to ensure each mcs artifact is available in the latest build
2019-08-24 fixed qspi instance and io naming
    [aardonyx.v]
2019-09-11 connected interrupt from plic to e-class
2019-09-17 adding one more i2c to aardonyx soc
2019-09-17 updating to latest i2c
2019-09-24 updating devices with pwm fix
2019-09-25 Resolve "Adding verification repository for e-class-aardonyx"
    [IS42s32160.v, aardonyx.v, constraints.xdc, encoding.h, fpga_top.v, gpio.h]
2019-11-21 Resolve "boot code for aardonyx"
    [aardonyx.v]
2019-11-21 Resolve "Adding test cases for peripherals"
    [gpio.h, log.h, pwm_driver.c, pwm_driver.h, pwmled.c]
2019-11-29 Added SPI and QSPI flash connections
2019-12-03 Resolve "aardonyx fpga fixes"
    [constraints.xdc, encoding.h, syscalls_e.c]
2019-12-03 Resolve "testbench for aardonyx wrapper"
    [aardonyx_wrapper.v]
2019-12-04 Added QSPI and SPI connections
2019-12-06 inverting outen signals of sdram in aardonyx_wrapper.v
    [aardonyx_wrapper.v]
2019-12-08 Reverted the out enable changes in aardonyx_wrapper; changes in SDRAM data line connections
    [aardonyx_wrapper.v, issiwrapper_aardonyx.v]
2019-12-09 Changed in UART connection in testbench and driver file changes
2019-12-10 Adding I2C to the tetbench
2019-12-10 peripheral tests for QSPI and SPI
2019-12-11 Test codes for i2c
2019-12-12 Hello world printf test
2019-12-12 adding testbench for uart1
2019-12-12 Verified SPI connected to Pinmux
2019-12-12 bsv wrapper for i2c
2019-12-15 Driver code for UART with pinmux configuration
2019-12-15 Connections for pinmux UARTs
2019-12-16 Drivers for PWM verification
2019-12-16 adding I2C software
2019-12-16 Different syscalls based on uart address
2019-12-17 Adding I2C tests
2019-12-17 removing I2C_tests from main folder
2019-12-17 adding Aardonyx board design
    [Aardonyx.sch, arduino_header.sch, ftdi.sch, power.sch, sdram.sch, soc.sch]
2019-12-17 reverting 35t devices version to fit within fpga. Async resets have created an issue
2019-12-19 Modified the default value of UART RX pin
2019-12-25 Resolve "uart interrupt feature"
2019-12-27 Resolve "Aardonyx wrapper verification"
    [rdgpio.c, spi_0.c, spi_0.h, spi_1.c, spi_1.h, spi_2.c, spi_2.h, tglgpio.c]
2020-01-16 Resolve "aardonyx wrapper testbench changes"
    [syscalls_1.c, syscalls_2.c]
2020-01-24 Use vivado_lab in case vivado is not present
    vivado_lab is free and can be used by developers to program
    the target.
2020-01-27 Resolve "e-class fpga with devices update"
    [constraints.xdc, fpga_top.v]
