Rajssss/shakti-soc/(notices)

Notices in the files:
asic/e-class-aardonyx/fpga/test/artya7-100t/peripheral-tests/bsp/drivers/leds/led_driver.c:
This program is free software: you can redistribute it and/or modify
it under the terms of the GNU General Public License as published by
the Free Software Foundation, either version 3 of the License, or
(at your option) any later version.
asic/e-class-aardonyx/fpga/test/artya7-100t/peripheral-tests/bsp/include/encoding.h:
Copyright (c) 2010-2017, The Regents of the University of California
(Regents). All Rights Reserved.
